RainbowLabsDE/TheL-MPAN/README.md

# TheLÄMPAN
Für so ne Lampe von IKEA ein Custom PCB
