RainbowLabsDE/TheL-MPAN/Hardware/LEDTischLampe.kicad_pcb

## KiCad design Hardware/LEDTischLampe.kicad_pcb (2024-10-23)

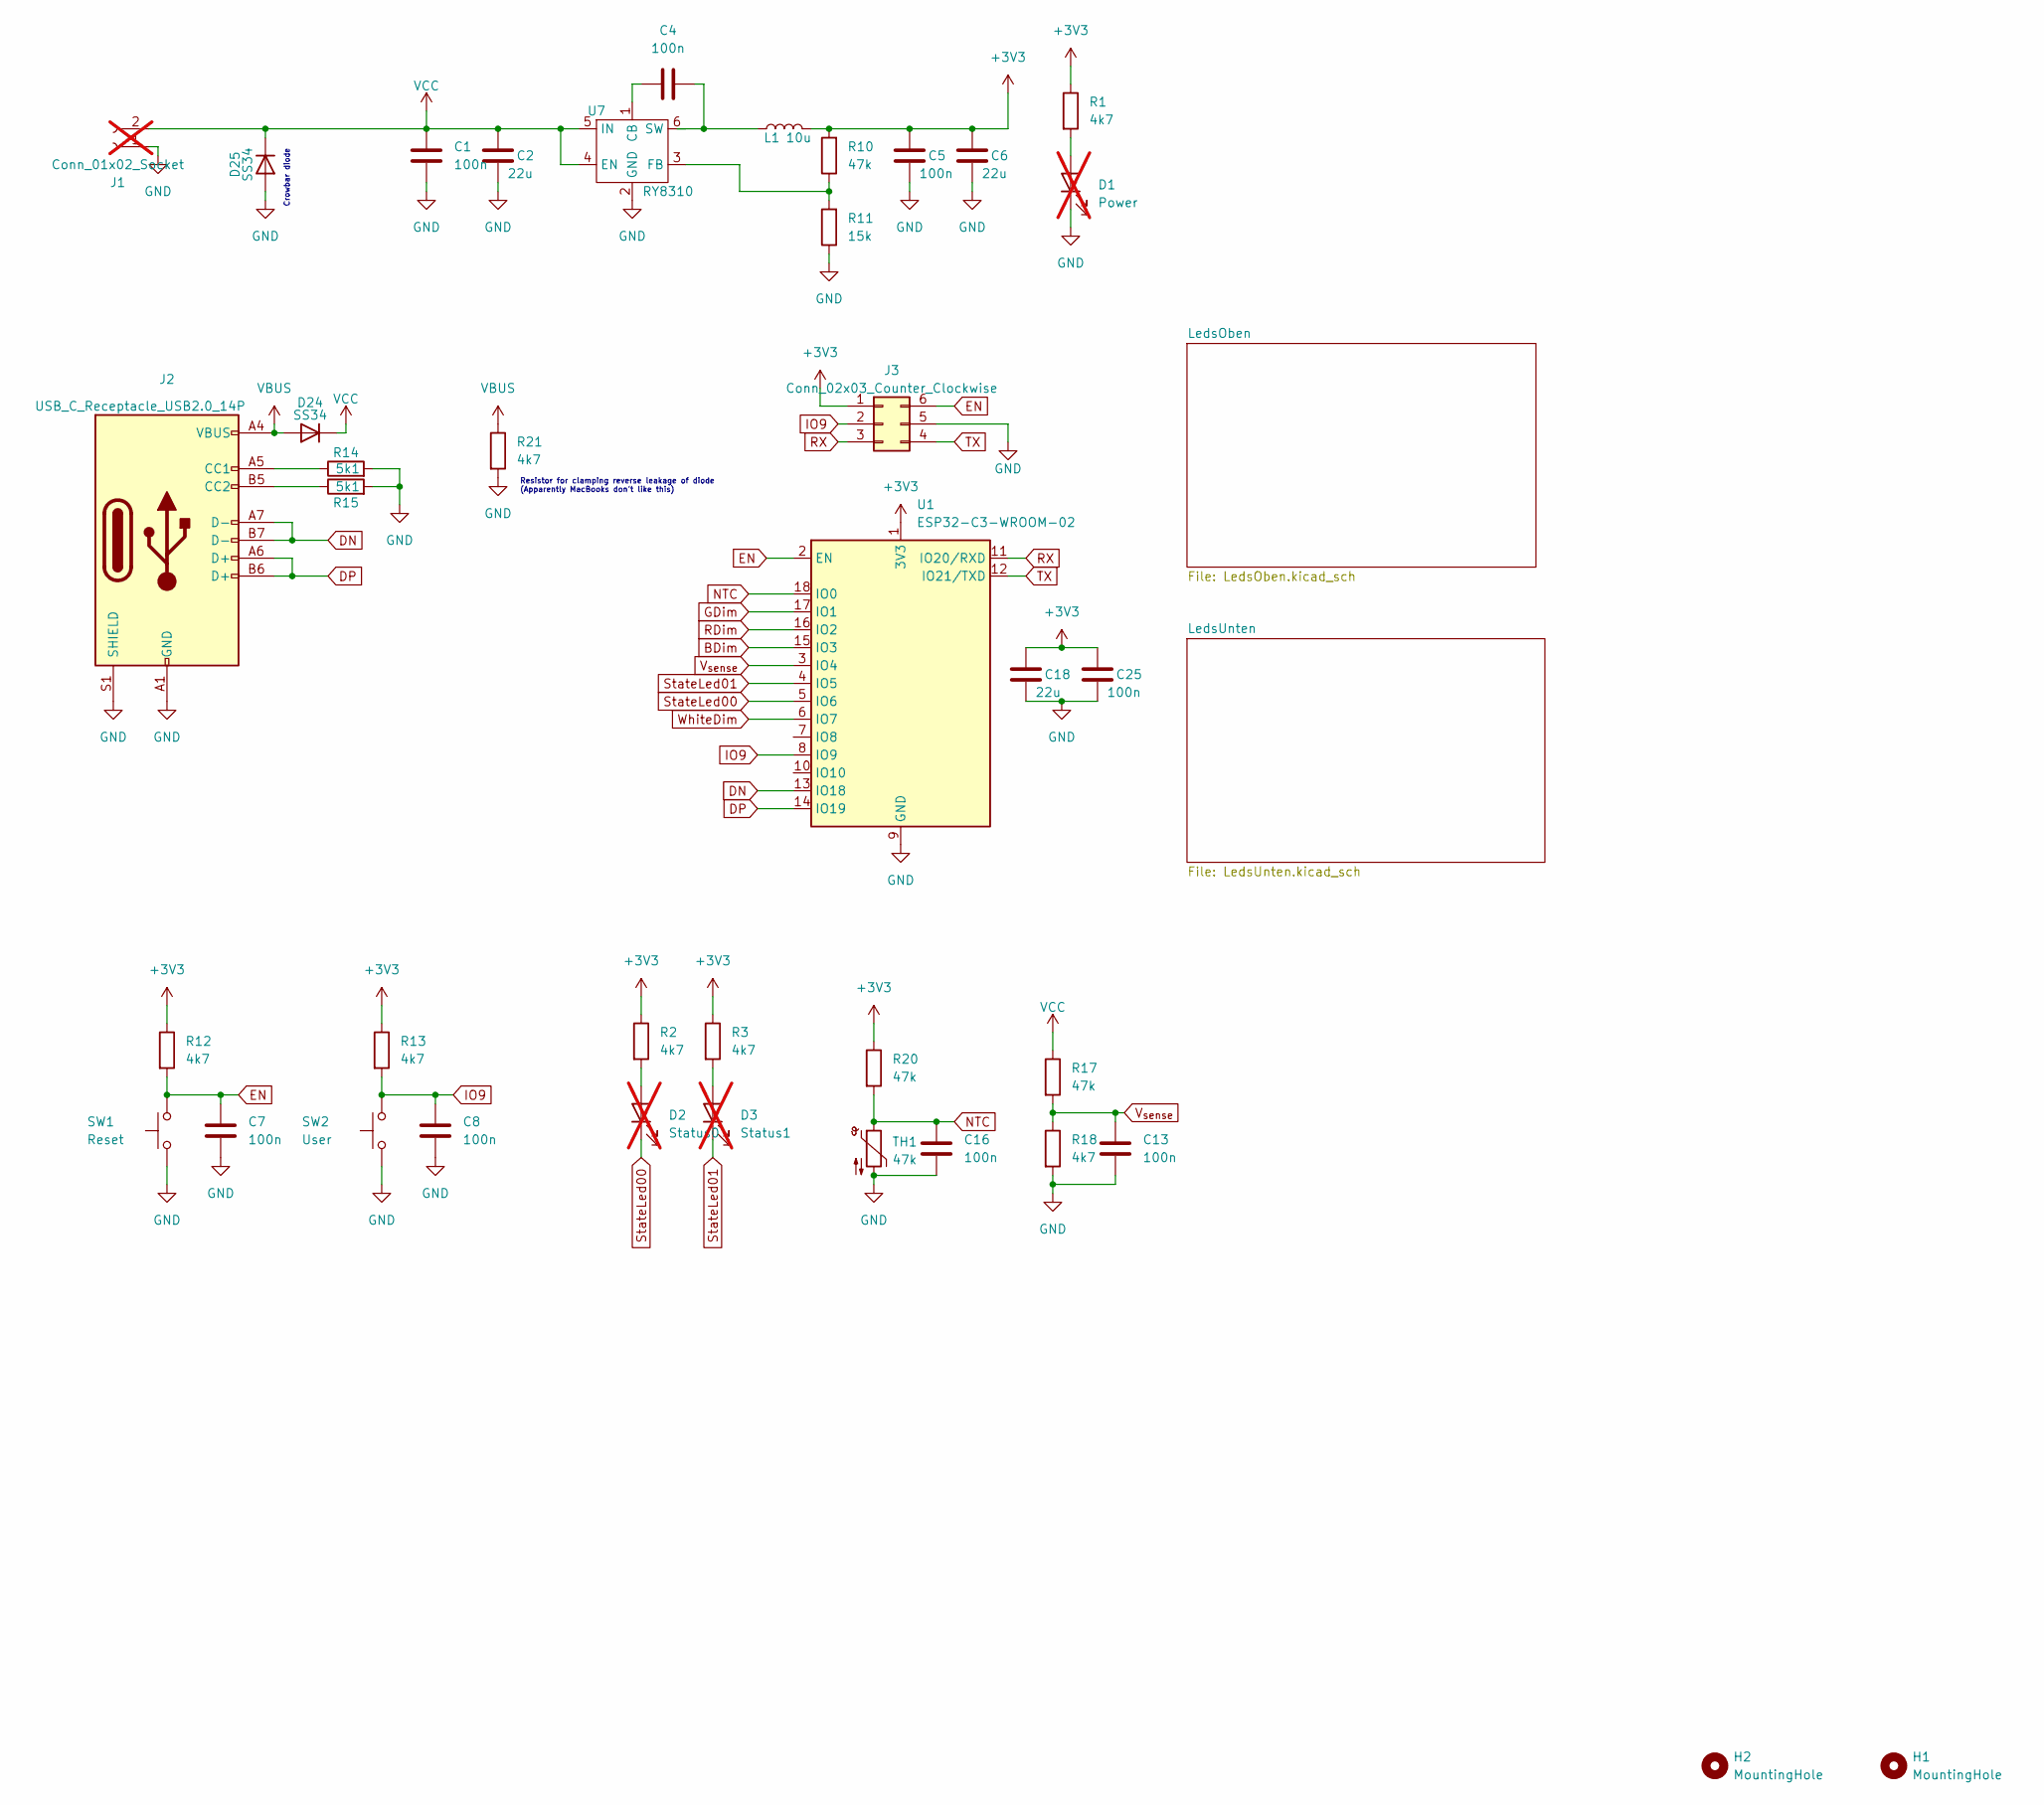
[picture p1: schematic LEDTischLampe.kicad_sch]

Parts:
C1, C4, C5, C7, C8, C13, C16, C25: 100n; C_0402_1005Metric
C2, C6, C18: 22u; C_0805_2012Metric
D1: Power; LED_0805_2012Metric; not fitted
D2: Status0; LED_0805_2012Metric; not fitted
D3: Status1; LED_0805_2012Metric; not fitted
D24, D25: SS34; D_SMA
H1, H2: MountingHole; MountingHole_3.2mm_M3
J1: Conn_01x02_Socket; TerminalBlock_Phoenix_PT-1,5-2-5.0-H_1x02_P5.00mm_Horizontal; not fitted
J2: USB_C_Receptacle_USB2.0_14P; USB-C_SMD-TYPE-C-31-M-12
J3: Conn_02x03_Counter_Clockwise; Tag-Connect_TC2030-IDC-NL_2x03_P1.27mm_Vertical
L1: 10u; IND-SMD_L2.5-W2.0
R1, R2, R3, R12, R13, R18, R21: 4k7; R_0402_1005Metric
R10, R17, R20: 47k; R_0402_1005Metric
R11: 15k; R_0402_1005Metric
R14, R15: 5k1; R_0402_1005Metric
SW1: Reset; SW_SPST_TL3342
SW2: User; SW_SPST_TL3342
TH1: 47k; R_0402_1005Metric
U1: ESP32-C3-WROOM-02
U7: RY8310; SOT-23-6

Connections:
+3V3: C5.1, C6.1, C18.1, C25.1, J3.1, L1.2, R1.1, R2.1, R3.1, R10.2, R12.1, R13.1, R20.1, U1.1 (3V3)
BDim: U1.15 (IO3); also elsewhere on the board
DN: J2.A7 (D-), J2.B7 (D-), U1.13 (IO18)
DP: J2.A6 (D+), J2.B6 (D+), U1.14 (IO19)
EN: C7.1, J3.6, R12.2, SW1.2, U1.2 (EN)
GDim: U1.17 (IO1); also elsewhere on the board
GND: C1.2, C2.2, C5.2, C6.2, C7.2, C8.2, C13.2, C16.2, C18.2, C25.2, D1.1 (K), D25.2 (A), J1.1, J2.A1 (GND), J2.A12 (GND), J2.B1 (GND), J2.B12 (GND), J2.S1 (SHIELD), J3.5, R11.1, R14.2, R15.2, R18.2, R21.2, SW1.1, SW2.1, TH1.2, U1.9 (GND), U1.19 (GND), U7.2 (GND); also elsewhere on the board
IO9: C8.1, J3.2, R13.2, SW2.2, U1.8 (IO9)
NTC: C16.1, R20.2, TH1.1, U1.18 (IO0)
unnamed: C4.2, L1.1
unnamed: D1.2 (A), R1.2
unnamed: D2.2 (A), R2.2
unnamed: D3.2 (A), R3.2
unnamed: J2.A5 (CC1), R14.1
unnamed: J2.B5 (CC2), R15.1
unnamed: C4.1, U7.1 (CB)
unnamed: R10.1, R11.2, U7.3 (FB)
RDim: U1.16 (IO2); also elsewhere on the board
RX: J3.3, U1.11 (IO20/RXD)
StateLed00: D2.1 (K), U1.5 (IO6)
StateLed01: D3.1 (K), U1.4 (IO5)
TX: J3.4, U1.12 (IO21/TXD)
VBUS: D24.2 (A), J2.A4 (VBUS), J2.A9 (VBUS), J2.B4 (VBUS), J2.B9 (VBUS), R21.1
VCC: C1.1, C2.1, D24.1 (K), D25.1 (K), J1.2, R17.1, U7.4 (EN), U7.5 (IN); also elsewhere on the board
V_{sense}: C13.1, R17.2, R18.1, U1.3 (IO4)
WhiteDim: U1.6 (IO7); also elsewhere on the board

Notes on the sheet:
Crowbar diode
Resistor for clamping reverse leakage of diode (Apparently MacBooks don't like this)

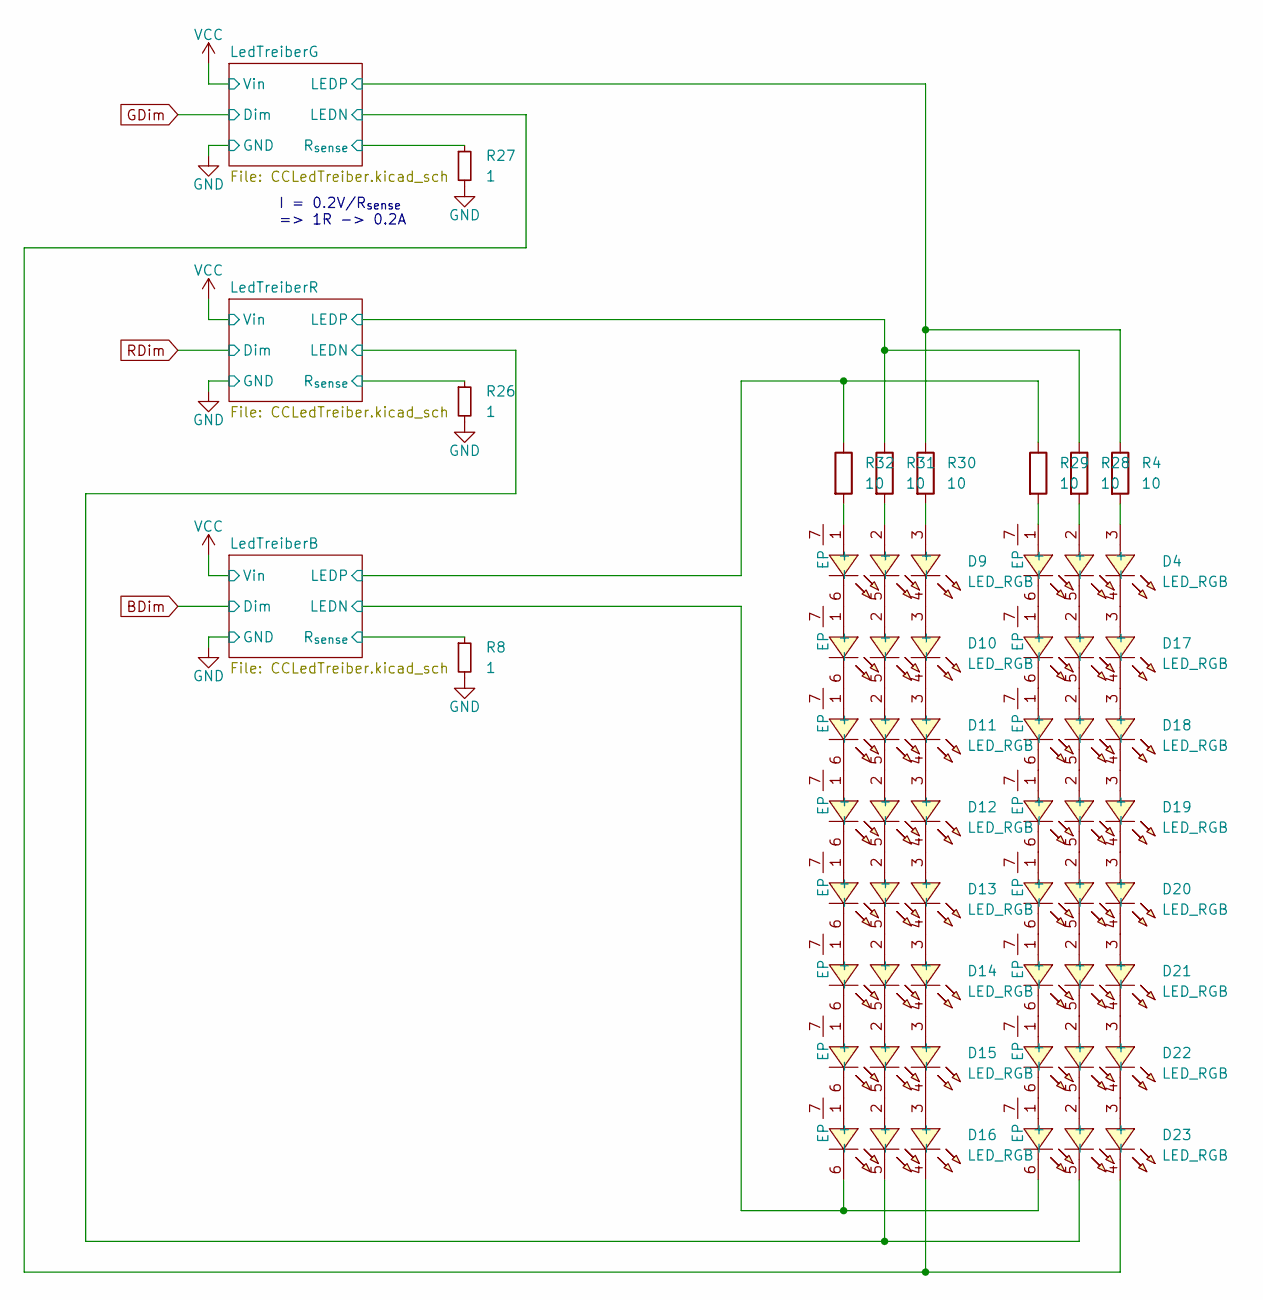
[picture p2: schematic LedsOben.kicad_sch]

Parts:
D4, D9, D10, D11, D12, D13, D14, D15, D16, D17, D18, D19, D20, D21, D22, D23: LED_RGB; LED-SMD_6P-L5.0-W5.0-BL_TC5053RGBE60
R4, R28, R29, R30, R31, R32: 10; R_0805_2012Metric
R8, R26, R27: 1; R_0805_2012Metric

Connections:
/LedsOben/LedTreiberB/LEDN: D16.6 (-), D23.6 (-), R8.1; also elsewhere on the board
/LedsOben/LedTreiberB/LEDP: R29.1, R32.1; also elsewhere on the board
/LedsOben/LedTreiberG/LEDN: D16.4 (-), D23.4 (-), R27.1; also elsewhere on the board
/LedsOben/LedTreiberG/LEDP: R4.1, R30.1; also elsewhere on the board
/LedsOben/LedTreiberR/LEDN: D16.5 (-), D23.5 (-), R26.1; also elsewhere on the board
/LedsOben/LedTreiberR/LEDP: R28.1, R31.1; also elsewhere on the board
GND: R8.2, R26.2, R27.2; also elsewhere on the board
unnamed: D4.1 (+), R29.2
unnamed: D4.2 (+), R28.2
unnamed: D4.3 (+), R4.2
unnamed: D9.1 (+), R32.2
unnamed: D9.2 (+), R31.2
unnamed: D9.3 (+), R30.2
unnamed: D9.6 (-), D10.1 (+)
unnamed: D9.5 (-), D10.2 (+)
unnamed: D9.4 (-), D10.3 (+)
unnamed: D10.4 (-), D11.3 (+)
unnamed: D10.5 (-), D11.2 (+)
unnamed: D10.6 (-), D11.1 (+)
unnamed: D11.4 (-), D12.3 (+)
unnamed: D11.5 (-), D12.2 (+)
unnamed: D11.6 (-), D12.1 (+)
unnamed: D12.4 (-), D13.3 (+)
unnamed: D12.5 (-), D13.2 (+)
unnamed: D12.6 (-), D13.1 (+)
unnamed: D13.4 (-), D14.3 (+)
unnamed: D13.5 (-), D14.2 (+)
unnamed: D13.6 (-), D14.1 (+)
unnamed: D14.4 (-), D15.3 (+)
unnamed: D14.5 (-), D15.2 (+)
unnamed: D14.6 (-), D15.1 (+)
unnamed: D15.4 (-), D16.3 (+)
unnamed: D15.5 (-), D16.2 (+)
unnamed: D15.6 (-), D16.1 (+)
unnamed: D4.6 (-), D17.1 (+)
unnamed: D4.5 (-), D17.2 (+)
unnamed: D4.4 (-), D17.3 (+)
unnamed: D17.4 (-), D18.3 (+)
unnamed: D17.5 (-), D18.2 (+)
unnamed: D17.6 (-), D18.1 (+)
unnamed: D18.4 (-), D19.3 (+)
unnamed: D18.5 (-), D19.2 (+)
unnamed: D18.6 (-), D19.1 (+)
unnamed: D19.4 (-), D20.3 (+)
unnamed: D19.5 (-), D20.2 (+)
unnamed: D19.6 (-), D20.1 (+)
unnamed: D20.4 (-), D21.3 (+)
unnamed: D20.5 (-), D21.2 (+)
unnamed: D20.6 (-), D21.1 (+)
unnamed: D21.4 (-), D22.3 (+)
unnamed: D21.5 (-), D22.2 (+)
unnamed: D21.6 (-), D22.1 (+)
unnamed: D22.4 (-), D23.3 (+)
unnamed: D22.5 (-), D23.2 (+)
unnamed: D22.6 (-), D23.1 (+)

Notes on the sheet:
I = 0.2V/R_{sense} => 1R -> 0.2A

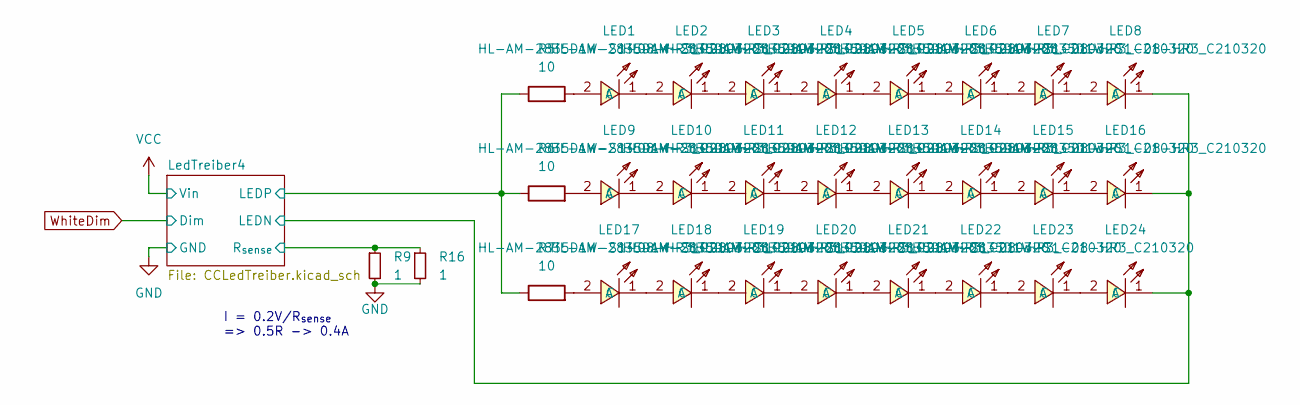
[picture p3: schematic LedsUnten.kicad_sch]

Parts:
LED1, LED2, LED3, LED4, LED5, LED6, LED7, LED8, LED9, LED10, LED11, LED12, LED13, LED14, LED15, LED16, LED17, LED18, LED19, LED20, LED21, LED22, LED23, LED24: HL-AM-2835D1W-S1-08-HR3_C210320; LED-SMD_L3.3-W2.8-RD
R5, R6, R7: 10; R_0805_2012Metric
R9, R16: 1; R_0805_2012Metric

Connections:
/LedsUnten/LedTreiber4/LEDN: LED8.1 (C), LED16.1 (C), LED24.1 (C), R9.1, R16.1; also elsewhere on the board
/LedsUnten/LedTreiber4/LEDP: R5.1, R6.1, R7.1; also elsewhere on the board
GND: R9.2, R16.2; also elsewhere on the board
unnamed: LED1.2 (A), R5.2
unnamed: LED1.1 (C), LED2.2 (A)
unnamed: LED2.1 (C), LED3.2 (A)
unnamed: LED3.1 (C), LED4.2 (A)
unnamed: LED4.1 (C), LED5.2 (A)
unnamed: LED5.1 (C), LED6.2 (A)
unnamed: LED6.1 (C), LED7.2 (A)
unnamed: LED7.1 (C), LED8.2 (A)
unnamed: LED9.2 (A), R6.2
unnamed: LED9.1 (C), LED10.2 (A)
unnamed: LED10.1 (C), LED11.2 (A)
unnamed: LED11.1 (C), LED12.2 (A)
unnamed: LED12.1 (C), LED13.2 (A)
unnamed: LED13.1 (C), LED14.2 (A)
unnamed: LED14.1 (C), LED15.2 (A)
unnamed: LED15.1 (C), LED16.2 (A)
unnamed: LED17.2 (A), R7.2
unnamed: LED17.1 (C), LED18.2 (A)
unnamed: LED18.1 (C), LED19.2 (A)
unnamed: LED19.1 (C), LED20.2 (A)
unnamed: LED20.1 (C), LED21.2 (A)
unnamed: LED21.1 (C), LED22.2 (A)
unnamed: LED22.1 (C), LED23.2 (A)
unnamed: LED23.1 (C), LED24.2 (A)

Notes on the sheet:
I = 0.2V/R_{sense} => 0.5R -> 0.4A

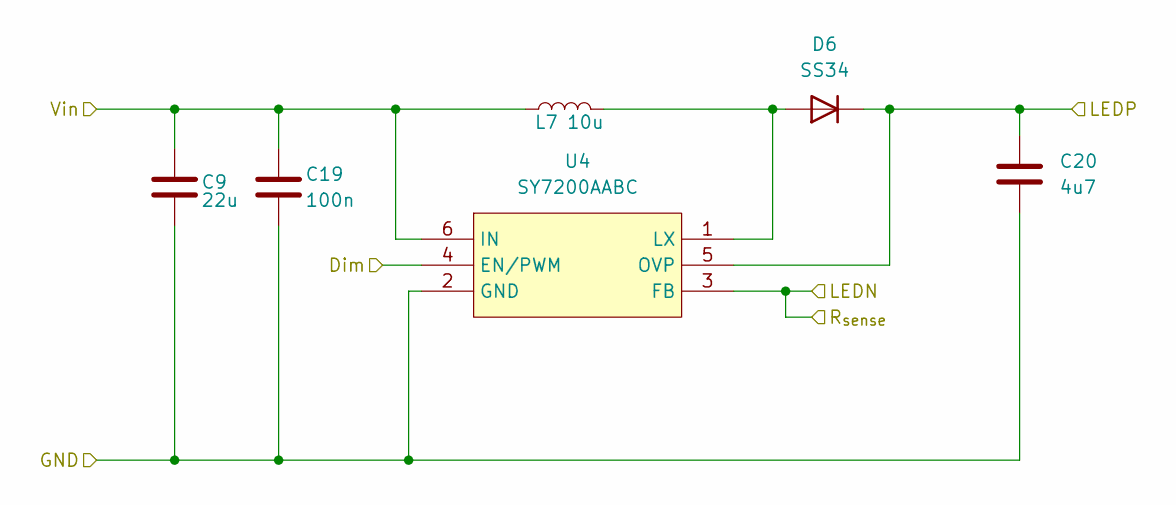
[picture p4: schematic CCLedTreiber.kicad_sch]

Parts:
C9: 22u; C_0805_2012Metric
C19: 100n; C_0402_1005Metric
C20: 4u7; C_1206_3216Metric
D6: SS34; D_SMA
L7: 10u; IND-SMD_L2.5-W2.0
U4: SY7200AABC; SOT-23-6_L2.9-W1.6-P0.95-LS2.8-BR

Connections:
/LedsOben/LedTreiberB/LEDN: U4.3 (FB); also elsewhere on the board
/LedsOben/LedTreiberB/LEDP: C20.1, D6.1 (K), U4.5 (OVP); also elsewhere on the board
BDim: U4.4 (EN/PWM); also elsewhere on the board
GND: C9.2, C19.2, C20.2, U4.2 (GND); also elsewhere on the board
unnamed: D6.2 (A), L7.2, U4.1 (LX)
VCC: C9.1, C19.1, L7.1, U4.6 (IN); also elsewhere on the board

Parts of its further copies:
C3, C21, C23: 100n; C_0402_1005Metric
C10, C11, C12: 22u; C_0805_2012Metric
C17, C22, C24: 4u7; C_1206_3216Metric
D5, D7, D8: SS34; D_SMA
L8, L9, L10: 10u; IND-SMD_L2.5-W2.0
U3, U5, U6: SY7200AABC; SOT-23-6_L2.9-W1.6-P0.95-LS2.8-BR

Connections of its further copies:
/LedsOben/LedTreiberG/LEDN: U6.3 (FB); also elsewhere on the board
/LedsOben/LedTreiberG/LEDP: C24.1, D8.1 (K), U6.5 (OVP); also elsewhere on the board
/LedsOben/LedTreiberR/LEDN: U5.3 (FB); also elsewhere on the board
/LedsOben/LedTreiberR/LEDP: C22.1, D7.1 (K), U5.5 (OVP); also elsewhere on the board
/LedsUnten/LedTreiber4/LEDN: U3.3 (FB); also elsewhere on the board
/LedsUnten/LedTreiber4/LEDP: C17.1, D5.1 (K), U3.5 (OVP); also elsewhere on the board
GDim: U6.4 (EN/PWM); also elsewhere on the board
GND: C3.2, C10.2, C11.2, C12.2, C17.2, C21.2, C22.2, C23.2, C24.2, U3.2 (GND), U5.2 (GND), U6.2 (GND); also elsewhere on the board
unnamed: D5.2 (A), L8.2, U3.1 (LX)
unnamed: D7.2 (A), L9.2, U5.1 (LX)
unnamed: D8.2 (A), L10.2, U6.1 (LX)
RDim: U5.4 (EN/PWM); also elsewhere on the board
VCC: C3.1, C10.1, C11.1, C12.1, C21.1, C23.1, L8.1, L9.1, L10.1, U3.6 (IN), U5.6 (IN), U6.6 (IN); also elsewhere on the board
WhiteDim: U3.4 (EN/PWM); also elsewhere on the board

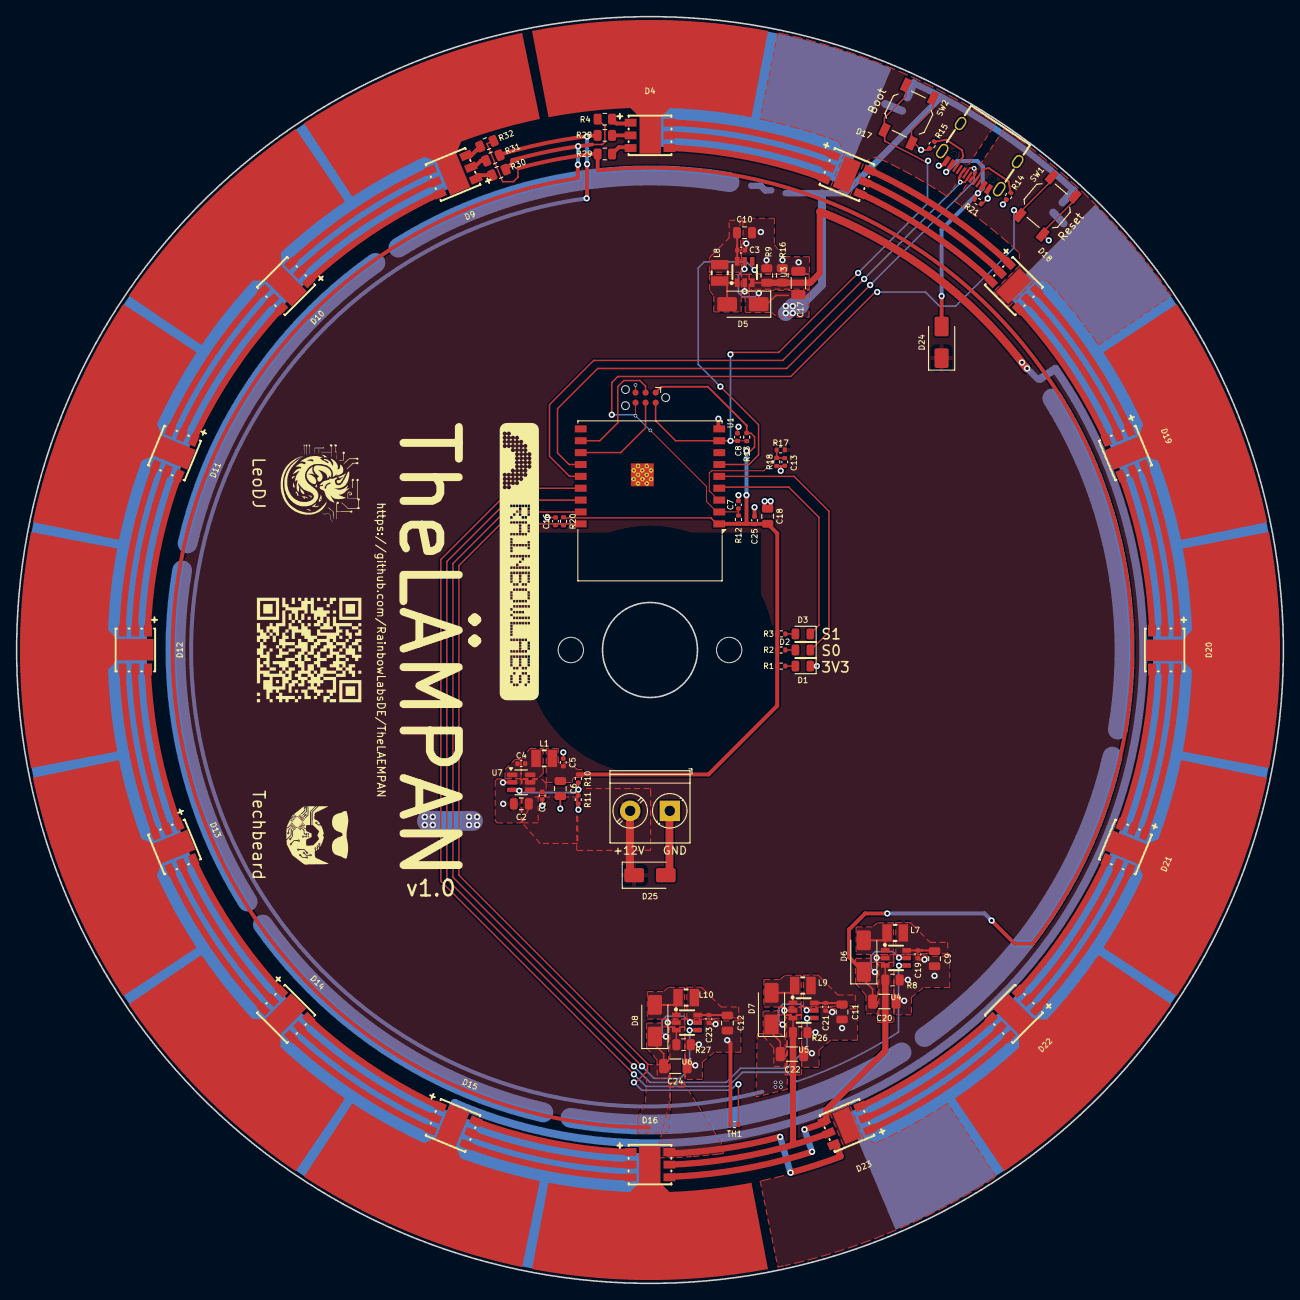
[picture p5: board LEDTischLampe.kicad_pcb from above]

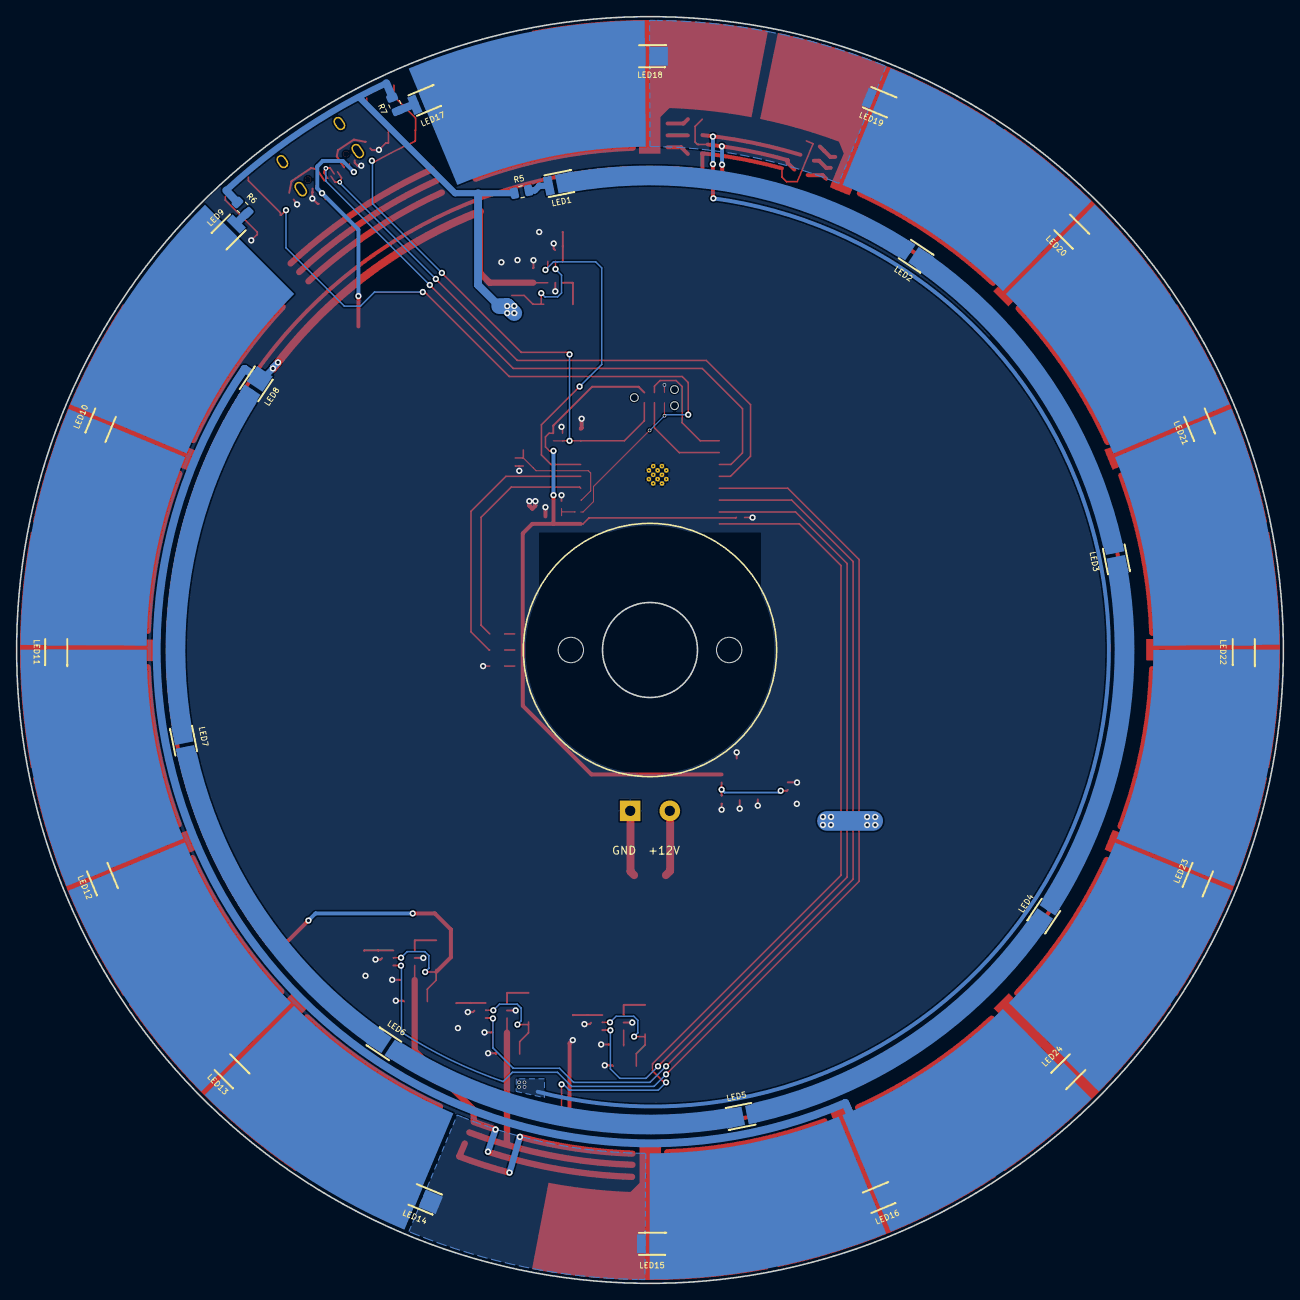
[picture p6: board LEDTischLampe.kicad_pcb from below]

Board: 2 copper layers, 160.0 x 160.0 mm, 118 parts (27 on the bottom side), 110 nets.
