RainbowLabsDE/TheL-MPAN/(commit log)

2024-10-09 edit layout
    [LEDTischLampe.kicad_pcb, LEDTischLampe.kicad_sch]
2024-10-09 a bit more layouting
    [LEDTischLampe.kicad_pcb]
2024-10-09 finished preliminary routing
    [LEDTischLampe.kicad_pcb, LEDTischLampe.kicad_sch, LedsUnten.kicad_sch]
2024-10-09 assign most LCSC numbers
    [CCLedTreiber.kicad_sch, LEDTischLampe.kicad_pcb, LEDTischLampe.kicad_sch]
2024-10-09 assign remaining LCSC numbers and change R_sense of LED drivers
    [CCLedTreiber.kicad_sch, LEDTischLampe.kicad_pcb, LedsOben.kicad_sch, LedsUnten.kicad_sch]
2024-10-09 remove LCSC numbers from silkscreen (bug in jlcpcb-tools)
    [CCLedTreiber.kicad_sch, LEDTischLampe.kicad_pcb, LEDTischLampe.kicad_sch, LedsOben.kicad_sch, LedsUnten.kicad_sch]
2024-10-09 generate new gerbers
    [LEDTischLampe-CuBottom.gbr, LEDTischLampe-CuTop.gbr, LEDTischLampe-EdgeCuts.gbr, LEDTischLampe-MaskBottom.gbr, LEDTischLampe-MaskTop.gbr, LEDTischLampe-NPTH.drl, LEDTischLampe-PTH.drl, LEDTischLampe-PasteBottom.gbr]
2024-10-10 some fixes and BOM optimization, heatsinking, etc
    [CCLedTreiber.kicad_sch, LEDTischLampe.kicad_pcb, LEDTischLampe.kicad_sch, LedsOben.kicad_sch, LedsUnten.kicad_sch]
2024-10-10 silkscreen and stuff
    [LEDTischLampe-CuBottom.gbr, LEDTischLampe-CuTop.gbr, LEDTischLampe-EdgeCuts.gbr, LEDTischLampe-MaskBottom.gbr, LEDTischLampe-MaskTop.gbr, LEDTischLampe-NPTH.drl, LEDTischLampe-PTH.drl, LEDTischLampe-PasteBottom.gbr]
2024-10-11 final touches for v1.0
    [BOM-LEDTischLampe.csv, CCLedTreiber.kicad_sch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]
2024-10-11 some more tweaks (rotated input terminal block, added voltage measurement)
    [BOM-LEDTischLampe.csv, CCLedTreiber.kicad_sch, LEDTischLampe.kicad_pcb, LEDTischLampe.kicad_sch, LedsUnten.kicad_sch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]
2024-10-23 update RGB mapping in KiCad
    [LEDTischLampe.kicad_pcb, LEDTischLampe.kicad_sch, LedsOben.kicad_sch, LedsUnten.kicad_sch]
